zwitterion/SpinCoaterController/parts.md

Motor:
DYS D2830 850KV
https://www.amazon.com/dp/B0D3DSGZGQ?ref_=ppx_hzsearch_conn_dt_b_fed_asin_title_2&th=1

RPM Sensor:
WWZMDiB 3Pcs 3.3-5V TCRT5000
https://www.amazon.com/dp/B0BDDBM2TR?ref=ppx_yo2ov_dt_b_fed_asin_title

3DPrinted Parts:
Fusion360 Model...

KASTLITE Clear Acrylic Disc – 1/8 Inch Thick Custom Size Round Plexi Glass Panel 
https://www.amazon.com/dp/B0DQYR1NHZ?ref_=ppx_hzsearch_conn_dt_b_fed_asin_title_4&th=1
