zwitterion/SpinCoaterController/SpinCoaterController/WebServer.cpp

#include "WebServer.h"
#include "ESCController.h"
#include <EEPROM.h>

// External reference to allow runtime PID updates
extern ESCController escController;
extern bool g_rpmCheckEnabled;

WebServer::WebServer(int port, ProfileManager& pm, ExecutionEngine& engine, EEPROMStorage& storage, WiFiManager& wifi)
    : _server(port), _pm(pm), _engine(engine), _storage(storage), _wifi(wifi), _wsConnected(false), _httpState(0), _contentLength(0) {
}

void WebServer::begin() {
    _server.begin();
}

void WebServer::update() {
    // 1. Check for new connections if not currently processing a request
    if (!_httpClient.connected()) {
        _httpClient = _server.available();
        if (_httpClient) {
            _httpState = 0; // State 0: Reading Headers
            _headerBuf = "";
            _bodyBuf = "";
            _contentLength = 0;
        }
    }

    // 2. Process active HTTP connection
    if (_httpClient.connected()) {
        // Non-blocking: only read if data is actually waiting in the buffer
        while (_httpClient.available()) {
            if (_httpState == 0) { // State 0: Accumulating Headers
                char c = _httpClient.read();
                _headerBuf += c;

                // Look for end of headers (\r\n\r\n)
                if (_headerBuf.endsWith("\r\n\r\n")) {
                    // Check for WebSocket Upgrade
                    if (_wsHandler.isUpgradeRequest(_headerBuf)) {
                        Serial.println("WS: Upgrade Request Detected");
                        if (_wsHandler.handleHandshake(_httpClient, _headerBuf)) {
                            Serial.println("WS: Handshake Success");
                            if (_wsConnected && _wsClient.connected()) _wsClient.stop();
                            _wsClient = _httpClient;
                            _wsConnected = true;
                            // Handshake complete, clear HTTP client
                            _httpClient = WiFiClient();
                        } else {
                            Serial.println("WS: Handshake Failed");
                            _httpClient.stop();
                        }
                        return; 
                    }

                    // Parse Request Line (Method and URI)
                    int firstSpace = _headerBuf.indexOf(' ');
                    int secondSpace = _headerBuf.indexOf(' ', firstSpace + 1);
                    if (firstSpace > 0 && secondSpace > firstSpace) {
                        _method = _headerBuf.substring(0, firstSpace);
                        _uri = _headerBuf.substring(firstSpace + 1, secondSpace);
                    }

                    // Parse Content-Length for POST/PUT bodies
                    int clIndex = _headerBuf.indexOf("Content-Length: ");
                    if (clIndex != -1) {
                        int clEnd = _headerBuf.indexOf("\r\n", clIndex);
                        _contentLength = _headerBuf.substring(clIndex + 16, clEnd).toInt();
                    }

                    if (_contentLength > 0) {
                        _httpState = 1; // Transition to state 1: Reading Body
                    } else {
                        handleApiRequest(_httpClient, _method, _uri, "");
                        _httpClient.stop();
                        return;
                    }
                }
            }
            else if (_httpState == 1) { // State 1: Accumulating Body
                _bodyBuf += (char)_httpClient.read();
                
                if (_bodyBuf.length() >= (unsigned int)_contentLength) {
                    handleApiRequest(_httpClient, _method, _uri, _bodyBuf);
                    _httpClient.stop();
                    return;
                }
            }
        }

        // Check for client timeout to prevent dead connections from hanging the state machine
        static unsigned long lastCheck = 0;
        if (millis() - lastCheck > 5000) { // 5s timeout
            lastCheck = millis();
            if (_httpClient.connected() && _httpClient.available() == 0) {
                // If we've been in a reading state with no data for too long, clear it
                _httpClient.stop();
            }
        }
    }

    // 3. Handle persistent WebSocket telemetry
    handleWebSocket();
}

void WebServer::handleWebSocket() {
    if (_wsConnected) {
        if (!_wsClient.connected()) {
            _wsConnected = false;
            return;
        }
        
        // Drain incoming frames (we don't expect commands via WS, but must read to keep connection alive)
        String msg = _wsHandler.readFrame(_wsClient);
        // Optional: Handle incoming WS commands here if needed
    }
}

void WebServer::handleApiRequest(WiFiClient& client, String method, String uri, String body) {
    // Parse Query Parameters
    String path = uri;
    String query = "";
    int qIdx = uri.indexOf('?');
    if (qIdx != -1) {
        path = uri.substring(0, qIdx);
        query = uri.substring(qIdx + 1);
    }

    // 1. Serve Static UI
    if (path == "/" || path == "/index.html") {
        client.println("HTTP/1.1 200 OK");
        client.println("Content-Type: text/html");
        if (WEB_ASSETS_GZIPPED) {
            client.println("Content-Encoding: gzip");
        }
        client.print("Content-Length: ");
        client.println(INDEX_HTML_SIZE);
        client.println("Cache-Control: no-store, no-cache, must-revalidate, max-age=0");
        client.println("Pragma: no-cache");
        client.println("Connection: close");
        client.println();
        
        // Write PROGMEM buffer
        const uint8_t* ptr = INDEX_HTML;
        size_t remaining = INDEX_HTML_SIZE;
        uint8_t buf[64];
        while (remaining > 0) {
            size_t chunk = (remaining > 64) ? 64 : remaining;
            memcpy_P(buf, ptr, chunk);
            client.write(buf, chunk);
            ptr += chunk;
            remaining -= chunk;
        }
        return;
    }

    // 2. API: Profiles
    if (path == "/profiles") {
        if (method == "GET") {
            JsonDocument doc;
            if (query.startsWith("id=")) {
                int id = query.substring(3).toInt();
                SpinProfile p;
                if (_pm.getProfile(id, p)) {
                    doc["id"] = p.id;
                    doc["name"] = p.name;
                    JsonArray steps = doc["steps"].to<JsonArray>();
                    for(int i=0; i<p.stepCount; i++) {
                        JsonObject s = steps.add<JsonObject>();
                        s["startRPM"] = p.steps[i].startRPM;
                        s["targetRPM"] = p.steps[i].targetRPM;
                        s["rampDurationMs"] = p.steps[i].rampDurationMs;
                        s["holdDurationMs"] = p.steps[i].holdDurationMs;
                        s["rampType"] = (int)p.steps[i].rampType;
                    }
                    sendJsonResponse(client, 200, doc);
                } else {
                    client.println("HTTP/1.1 404 Not Found\r\n\r\n");
                }
            } else {
                _pm.getProfileList(doc);
                sendJsonResponse(client, 200, doc);
            }
        } 
        else if (method == "POST") {
            JsonDocument doc;
            DeserializationError error = deserializeJson(doc, body);
            if (!error) {
                SpinProfile p;
                memset(&p, 0, sizeof(SpinProfile)); // Zero-init to prevent garbage in padding/unused steps
                
                p.id = doc["id"] | 255;
                
                const char* nameStr = doc["name"];
                if (nameStr && strlen(nameStr) > 0) {
                    strncpy(p.name, nameStr, sizeof(p.name) - 1);
                } else {
                    strncpy(p.name, "Unnamed Profile", sizeof(p.name) - 1);
                }
                p.name[sizeof(p.name) - 1] = '\0';
                
                JsonArray steps = doc["steps"];
                p.stepCount = 0;
                for(JsonObject s : steps) {
                    if(p.stepCount >= 20) break;
                    p.steps[p.stepCount].startRPM = s["startRPM"];
                    p.steps[p.stepCount].targetRPM = s["targetRPM"];
                    p.steps[p.stepCount].rampDurationMs = s["rampDurationMs"];
                    p.steps[p.stepCount].holdDurationMs = s["holdDurationMs"];
                    p.steps[p.stepCount].rampType = (RampType)s["rampType"].as<int>();
                    p.stepCount++;
                }
                
                if (_pm.createProfile(p)) {
                    client.println("HTTP/1.1 200 OK\r\n\r\n");
                } else {
                    client.println("HTTP/1.1 500 Error Saving\r\n\r\n");
                }
            } else {
                client.println("HTTP/1.1 400 Bad JSON\r\n\r\n");
            }
        }
        else if (method == "DELETE") {
            if (query.startsWith("id=")) {
                int id = query.substring(3).toInt();
                _pm.deleteProfile(id);
                client.println("HTTP/1.1 200 OK\r\n\r\n");
            }
        }
        return;
    }

    // 3. API: Commands
    if (path.startsWith("/run/")) {
        int id = path.substring(5).toInt();
        Serial.print("CMD: Run Profile ID "); Serial.println(id);
        _engine.runProfile(id);
        client.println("HTTP/1.1 200 OK\r\n\r\n");
        return;
    }
    
    if (path == "/stop") {
        Serial.println("CMD: Stop");
        _engine.stop();
        client.println("HTTP/1.1 200 OK\r\n\r\n");
        return;
    }
    
    if (path == "/pause") {
        Serial.println("CMD: Pause");
        _engine.pause();
        client.println("HTTP/1.1 200 OK\r\n\r\n");
        return;
    }

    // 4. API: Settings
    if (path == "/settings") {
        if (method == "GET") {
            SystemSettings s;
            _storage.loadSettings(s);
            
            JsonDocument doc;
            doc["pid"]["kp"] = s.pid.kp;
            doc["pid"]["ki"] = s.pid.ki;
            doc["pid"]["kd"] = s.pid.kd;
            doc["pid"]["alpha"] = s.filterAlpha;
            doc["pid"]["windup"] = s.windupRange;
            doc["sys"]["maxRPM"] = s.maxRPM;
            doc["sys"]["calibrated"] = s.escCalibrated;
            doc["sys"]["controlMode"] = (int)s.controlMode;
            doc["sys"]["rpmCheck"] = g_rpmCheckEnabled;
            doc["sys"]["mapSlope"] = s.mapSlope;
            doc["sys"]["mapIntercept"] = s.mapIntercept;
            doc["sys"]["mapStartPWM"] = s.mapStartPWM;
            
            // Ensure strings are treated as clean null-terminated pointers
            s.wifi.ssid[32] = '\0';
            s.wifi.hostname[32] = '\0';
            doc["wifi"]["ssid"] = (const char*)s.wifi.ssid;
            doc["wifi"]["hostname"] = (const char*)s.wifi.hostname;
            // Don't send password back
            
            sendJsonResponse(client, 200, doc);
        } 
        else if (method == "POST") {
            JsonDocument doc;
            if (!deserializeJson(doc, body)) {
                SystemSettings s;
                _storage.loadSettings(s); // Load existing to preserve what isn't sent
                
                if (doc.containsKey("pid")) {
                    s.pid.kp = doc["pid"]["kp"];
                    s.pid.ki = doc["pid"]["ki"];
                    s.pid.kd = doc["pid"]["kd"];
                    s.filterAlpha = doc["pid"]["alpha"] | 1.0f;
                    s.windupRange = doc["pid"]["windup"] | 500.0f;
                    
                    // Apply Runtime PID Update
                    escController.setPID(s.pid.kp, s.pid.ki, s.pid.kd);
                    escController.setFilterAlpha(s.filterAlpha);
                    escController.setWindupRange(s.windupRange);
                }
                
                if (doc.containsKey("sys")) {
                    JsonObject sys = doc["sys"];
                    if (sys.containsKey("maxRPM")) s.maxRPM = sys["maxRPM"];
                    if (sys.containsKey("calibrated")) s.escCalibrated = sys["calibrated"];
                    if (sys.containsKey("controlMode")) s.controlMode = (ControlMode)sys["controlMode"].as<int>();
                    
                    if (sys.containsKey("rpmCheck")) {
                        g_rpmCheckEnabled = sys["rpmCheck"];
                        EEPROM.put(510, g_rpmCheckEnabled);
                    }
                }

                if (doc.containsKey("wifi")) {
                    const char* ssid = doc["wifi"]["ssid"];
                    const char* pass = doc["wifi"]["pass"];
                    const char* hostname = doc["wifi"]["hostname"];
                    if (ssid && strlen(ssid) > 0) {
                        strncpy(s.wifi.ssid, ssid, 32); 
                        s.wifi.ssid[32] = '\0';
                        if (pass && strlen(pass) > 0) {
                            strncpy(s.wifi.password, pass, 64);
                            s.wifi.password[64] = '\0';
                        }
                        if (hostname && strlen(hostname) > 0) {
                            strncpy(s.wifi.hostname, hostname, 32);
                            s.wifi.hostname[32] = '\0';
                        }
                        s.wifi.valid = true;
                    }
                }
                
                _storage.saveSettings(s);
                // Apply runtime changes to ESC controller
                
                if (!g_rpmCheckEnabled) {
                    escController.setControlMode(CONTROL_KV);
                } else {
                    escController.setControlMode((int)s.controlMode);
                }
                
                escController.setMappingParams(s.mapSlope, s.mapStartPWM);
                client.println("HTTP/1.1 200 OK\r\n\r\n");
            }
        }
        return;
    }

    // 5. API: Factory Reset
    if (path == "/reset" && method == "POST") {
        _storage.wipe();
        client.println("HTTP/1.1 200 OK\r\n\r\n");
        return;
    }

    // 6. API: Reboot
    if (path == "/reboot" && method == "POST") {
        client.println("HTTP/1.1 200 OK\r\n\r\n");
        client.stop();
        delay(100);
        NVIC_SystemReset();
        return;
    }

    // 7. API: Tune
    if (path == "/tune" && method == "POST") {
        Serial.println("CMD: Start Tuning");
        _engine.startTuning();
        client.println("HTTP/1.1 200 OK\r\n\r\n");
        return;
    }

    // 8. API: Manual Control
    if (path == "/manual" && method == "POST") {
        JsonDocument doc;
        deserializeJson(doc, body);
        if (doc.containsKey("enable") && doc["enable"].as<bool>()) {
            _engine.startManual();
        }
        if (doc.containsKey("rpm")) {
            _engine.setManualRPM(doc["rpm"]);
        }
        client.println("HTTP/1.1 200 OK\r\n\r\n");
        return;
    }

    // 10. API: PWM Mapping
    if (path == "/startMap" && method == "POST") {
        JsonDocument doc;
        DeserializationError error = deserializeJson(doc, body);
        
        if (error) {
            Serial.print("WebServer: Failed to parse /startMap JSON. Error: ");
            Serial.println(error.c_str());
            Serial.print("Raw Body: ");
            Serial.println(body);
            client.println("HTTP/1.1 400 Bad Request\r\n\r\n");
            return;
        }

        int start = doc["start"] | 1000;
        int end = doc["end"] | 2000;
        int step = doc["step"] | 20;

        Serial.println("--- PWM MAPPING START ---");
        Serial.print("Range: "); Serial.print(start); Serial.print("us to "); Serial.print(end); Serial.print("us | Step: "); Serial.println(step);
        _engine.startPwmMapping(start, end, step);
        client.println("HTTP/1.1 200 OK\r\n\r\n");
        return;
    }

    // 11. API: WiFi Scan
    if (path == "/scan" && method == "GET") {
        // Safety: only scan when motor is not running to avoid blocking control loop
        if (_engine.getTelemetry().state != STATE_IDLE) {
            client.println("HTTP/1.1 403 Forbidden\r\n\r\n");
            return;
        }
        int numSsid = WiFi.scanNetworks();
        JsonDocument doc;
        JsonArray networks = doc.to<JsonArray>();
        for (int i = 0; i < numSsid; i++) {
            JsonObject net = networks.add<JsonObject>();
            net["ssid"] = WiFi.SSID(i);
            net["rssi"] = WiFi.RSSI(i);
        }
        sendJsonResponse(client, 200, doc);
        return;
    }

    // 404
    client.println("HTTP/1.1 404 Not Found\r\n\r\n");
}

void WebServer::sendJsonResponse(WiFiClient& client, int statusCode, const JsonDocument& doc) {
    String response;
    serializeJson(doc, response);

    client.print("HTTP/1.1 ");
    client.print(statusCode);
    client.println(" OK");
    client.println("Content-Type: application/json");
    client.print("Content-Length: ");
    client.println(response.length());
    client.println("Connection: close");
    client.println();
    client.print(response);
    client.flush();
}

void WebServer::broadcastTelemetry(const TelemetryData& data) {
    if (!_wsConnected) return;

    // Check actual socket status
    if (!_wsClient.connected()) {
        _wsConnected = false;
        return;
    }
    
    JsonDocument doc;
    
    // Map Enum to String for UI
    switch(data.state) {
        case STATE_IDLE: doc["state"] = "IDLE"; break;
        case STATE_RUNNING: doc["state"] = "RUNNING"; break;
        case STATE_PAUSED: doc["state"] = "PAUSED"; break;
        case STATE_STOPPING: doc["state"] = "STOPPING"; break;
        case STATE_ERROR: doc["state"] = "ERROR"; break;
        case STATE_EMERGENCY_STOP: doc["state"] = "EMERGENCY"; break;
        case STATE_TUNING: doc["state"] = "TUNING"; break;
        case STATE_MANUAL: doc["state"] = "MANUAL"; break;
        case STATE_MAPPING: doc["state"] = "MAPPING"; break;
    }
    
    doc["rpm"] = data.currentRPM;
    doc["target"] = data.targetRPM;
    doc["step"] = data.currentStepIndex + 1; // 1-based for UI
    doc["timeRem"] = data.stepTimeRemaining;
    doc["total"] = data.stepTotalTime;
    doc["totalRem"] = data.totalTimeRemaining;
    doc["totalTime"] = data.totalProfileTime;
    doc["pId"] = data.profileId;
    doc["pulseWidth"] = data.pulseWidth;
    doc["throttlePercent"] = data.throttlePercent;
    doc["rssi"] = (WiFi.status() == WL_CONNECTED) ? WiFi.RSSI() : 0;
    doc["btnStart"] = data.btnStartPressed;
    doc["btnStop"] = data.btnStopPressed;

    // If we are in mapping mode, we send the current PWM/RPM as a mapPoint 
    // whenever a stabilization period (5s) completes.
    if (data.isMapPoint) {
        JsonObject mapPoint = doc["mapPoint"].to<JsonObject>();
        mapPoint["pwm"] = data.pulseWidth;
        mapPoint["rpm"] = data.currentRPM;
    }
    
    if (data.errorMessage) {
        doc["error"] = data.errorMessage;
    }
    
    String output;
    serializeJson(doc, output);
    _wsHandler.sendFrame(_wsClient, output);
}
