zwitterion/SpinCoaterController/SpinCoaterController/web_assets.h

#ifndef WEB_ASSETS_H
#define WEB_ASSETS_H

#include <Arduino.h>

// GZIP Compressed HTML
const bool WEB_ASSETS_GZIPPED = true;
const size_t INDEX_HTML_SIZE = 10077;
const uint8_t INDEX_HTML[] PROGMEM = {
0x1F, 0x8B, 0x08, 0x00, 0x98, 0x1C, 0xD3, 0x69, 0x02, 0xFF, 0xD5, 0x7D, 0xDB, 0x76, 0xDB, 0xC6, 0xB2, 0xE0, 0xBB, 0xBF, 0x02, 0x66, 0x1C, 0x07, 0x88, 0x41, 0xF0, 0x22, 0xD1, 0x51, 0x48, 0x81, 0x3A, 0x8E, 0xA4, 0xC4, 0x9A, 0xF8, 0xA2, 0x25, 0xC9, 0xC9, 0xC9, 0xCA, 0x78, 0x05, 0x10, 0xD1, 0x14, 0xB1, 0x05, 0x02, 0x38, 0x00, 0xA8, 0x4B, 0x68, 0x7E, 0xC3, 0xBC, 0xCE, 0x9A, 0xA7, 0xF3, 0x09, 0xE7, 0x65, 0xD6, 0x9A, 0xE7, 0xF9, 0x94, 0xF3, 0x03, 0xF3, 0x0B, 0x53, 0x55, 0xDD, 0x0D, 0x34, 0x2E, 0xA4, 0x28, 0x3B, 0x7B, 0xAF, 0x7D, 0xE2, 0xD8, 0x22, 0xFB, 0x52, 0x5D, 0x5D, 0x5D, 0x55, 0x5D, 0x55, 0x5D, 0xDD, 0xDA, 0x7F, 0xEA, 0x45, 0x93, 0xEC, 0x3E, 0x66, 0xDA, 0x2C, 0x9B, 0x07, 0xE3, 0x7D, 0xFC, 0x57, 0x0B, 0xDC, 0xF0, 0xCA, 0x66, 0xE1, 0x78, 0x7F, 0xCE, 0x32, 0x57, 0x9B, 0xCC, 0xDC, 0x24, 0x65, 0x99, 0xFD, 0xE1, 0xE2, 0xC7, 0xF6, 0x9E, 0x2C, 0x8B, 0xC2, 0x8C, 0x85, 0x99, 0xDD, 0xBA, 0xF5, 0xBD, 0x6C, 0x66, 0x7B, 0xEC, 0xC6, 0x9F, 0xB0, 0x36, 0x7D, 0x31, 0xFD, 0xD0, 0xCF, 0x7C, 0x37, 0x68, 0xA7, 0x13, 0x37, 0x60, 0x76, 0xCF, 0xEA, 0xB6, 0xB4, 0xD0, 0x9D, 0x33, 0xFB, 0xC6, 0x67, 0xB7, 0x71, 0x94, 0x64, 0xE3, 0xFD, 0xCC, 0xCF, 0x02, 0x36, 0x3E, 0x8F, 0xFD, 0xF0, 0x30, 0x72, 0x33, 0x96, 0xEC, 0x77, 0x78, 0xC9, 0x7E, 0x9A, 0xDD, 0xC3, 0x8F, 0x61, 0x12, 0x45, 0xD9, 0xB2, 0xDD, 0xBE, 0xBC, 0x6A, 0x4F, 0xA2, 0x20, 0x4A, 0x86, 0x5F, 0xF5, 0xFA, 0xF8, 0x67, 0xD4, 0x6E, 0x4F, 0xDC, 0xC4, 0x83, 0x72, 0x28, 0x61, 0xF8, 0x07, 0x4A, 0x32, 0x76, 0x97, 0xC9, 0x66, 0xAC, 0x8B, 0x7F, 0xA0, 0x30, 0x64, 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
0xC3, 0xB6, 0x1D, 0xF9, 0xDB, 0x00, 0x9C, 0x03, 0x07, 0x75, 0x89, 0x33, 0x2C, 0x4A, 0xE8, 0x7E, 0xD2, 0x49, 0xE8, 0x67, 0x4F, 0x2A, 0x2C, 0xE6, 0x43, 0x59, 0x1E, 0xCB, 0xAA, 0xE4, 0x28, 0x08, 0xF7, 0xA2, 0x14, 0xDB, 0xB0, 0xC7, 0x4A, 0x24, 0x2A, 0x31, 0xFB, 0xF8, 0xFE, 0x89, 0x68, 0x57, 0xCE, 0x60, 0xD8, 0xA2, 0xF3, 0x80, 0x3A, 0xE7, 0x0F, 0xD5, 0xAD, 0x38, 0x2E, 0xA3, 0xFD, 0x8E, 0x78, 0xC6, 0xEF, 0xFF, 0x03, 0x27, 0x24, 0x7A, 0x95, 0xEB, 0x8C, 0x00, 0x00
};

#endif
