zwitterion/SpinCoaterController/SpinCoaterController/ExecutionEngine.h

#ifndef EXECUTION_ENGINE_H
#define EXECUTION_ENGINE_H

#include "types.h"
#include "RPMReader.h"
#include "ESCController.h"
#include "SafetyManager.h"
#include "ProfileManager.h"
#include "EEPROMStorage.h"

class ExecutionEngine {
public:
    ExecutionEngine(RPMReader& rpm, ESCController& esc, SafetyManager& safety, ProfileManager& pm, EEPROMStorage& storage);
    
    void begin();
    void update();
    
    // Commands
    void runProfile(uint8_t profileId);
    void stop();
    void pause();
    void resume();
    void startTuning();
    void startManual();
    
    // Pass button states from main loop
    void setButtonStates(bool startPressed, bool stopPressed);
    void startPwmMapping(int start, int end, int step);
    void setManualRPM(float rpm);
    
    // Status
    TelemetryData getTelemetry();

private:
    RPMReader& _rpmReader;
    ESCController& _escController;
    SafetyManager& _safetyManager;
    ProfileManager& _profileManager;
    EEPROMStorage& _storage;
    
    SystemState _state;
    SpinProfile _currentProfile;
    
    int _currentStepIndex;
    unsigned long _stepStartTime;
    unsigned long _pauseStartTime;
    
    float _currentTargetRPM;
    float _manualTargetRPM;
    
    int _mappingPulseWidth;
    int _mappingEndPulse;
    int _lastRecordedPwm;
    int _mappingStep;
    bool _isMapPointRecorded;
    
    bool _btnStartPressed;
    bool _btnStopPressed;
    bool _lastBtnStart;

    // Regression Variables
    double _sumX;
    double _sumY;
    double _sumXY;
    double _sumX2;
    int _mappingCount;
    
    // Helper to calculate instantaneous target based on ramp
    float calculateRampRPM(const SpinStep& step, unsigned long elapsedStepTime);
    
    // Transition helpers
    void advanceStep();
};

#endif
