zwitterion/SpinCoaterController/(commit log)

2026-03-27 PID Autotune improvements
2026-04-01 replaced hobby ESC support with professional direct driver motor and controller (example: BLDC8015A)
    [EEPROMStorage.cpp, ESCController.cpp, ExecutionEngine.cpp, ExecutionEngine.h, R4ESC.cpp, R4ESC.h, SpinCoaterController.ino, WebServer.cpp]
2026-04-02 add stage progress bar
2026-04-05 webserver optimization and support for emergency stop (hardware button)
2026-04-05 code for 'start' (hardware button) and new profile step to wait for a button press
2026-04-06 start/stop physical button indicators
2026-04-06 removed pause button
